FelipeS901/Trabajo-prevencion-incendios/docs/Arquitectura Operativa por Capas.jpg

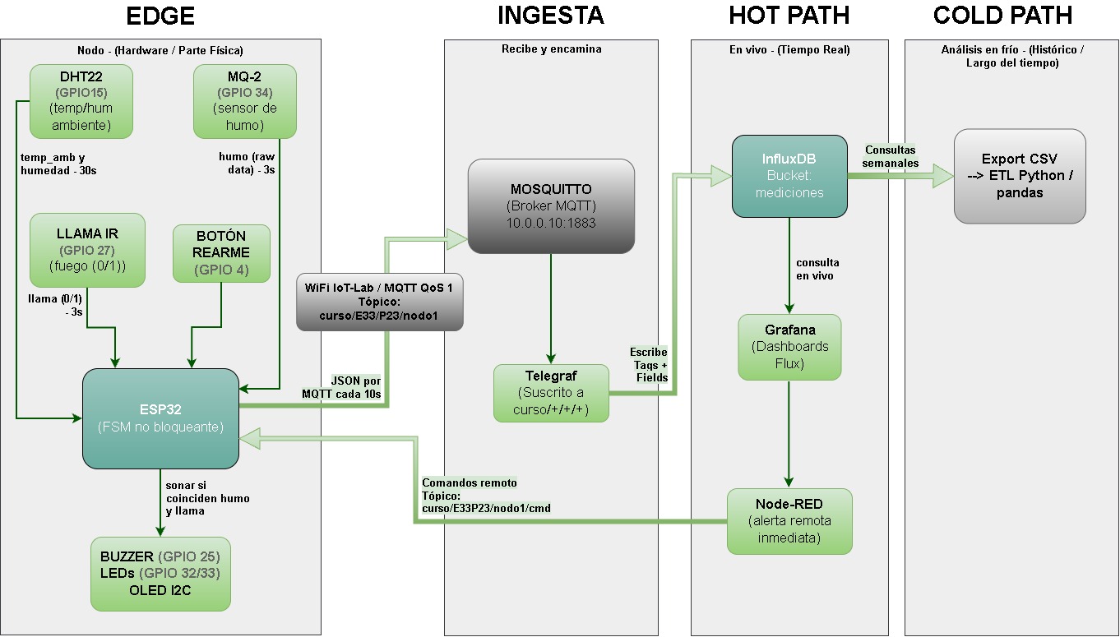
docs/Arquitectura Operativa por Capas.jpg
