FelipeS901/Trabajo-prevencion-incendios/README.md

# Nodo inteligente de detección de incendios

## Identificación del proyecto
- Equipo: **E33**
- Proyecto: **P23**
- Asignatura: **Fundamentos de IoT**
- Integrantes: Fiorella Bovet, Victoria Rojas, Felipe Stuardo, Arthur Urtubia y Javier Vidal

---

## Autoría y trazabilidad del firmware (Auditoría de contribuciones)

Para dar cumplimiento al criterio D7 (Autoría y trazabilidad) y a la retroalimentación de la Evaluación Regular 1, se detalla la contribución real de cada integrante del equipo E33.

### Hito 1: Evaluación Regular 1 — NP1: Nodo local

| Integrante | Módulo o tramo desarrollado | Evidencia |
| :--- | :--- | :--- |
| **Felipe Stuardo** | Gestión inicial del repositorio, organización de carpetas y creación de entregas. | [Historial de commits](https://github.com/FelipeS901/Trabajo-prevencion-incendios/commits/main/) |
| **Arthur Urtubia** | Desarrollo del código base, apoyo en las conexiones de hardware y realización de los cálculos matemáticos (calibración MQ-2, umbrales) necesarios para el funcionamiento del sistema. | [Código histórico de NP1](https://github.com/FelipeS901/Trabajo-prevencion-incendios/blob/main/CODIGOS/archivo-anterior/NP1_Codigo.ino) |
| **Javier Vidal** | Desarrollo del código base y apoyo en las conexiones de hardware. | [Código histórico de NP1](https://github.com/FelipeS901/Trabajo-prevencion-incendios/blob/main/CODIGOS/archivo-anterior/NP1_Codigo.ino) |
| **Fiorella Bovet** | Diseño de la máquina de estados, elaboración de diagramas, apoyo en la presentación y soldadura de componentes. | [Grafo de estados](https://github.com/FelipeS901/Trabajo-prevencion-incendios/blob/main/docs/Grafo-Estados.drawio) |
| **Victoria Rojas** | Elaboración de documentos de guía, organización del equipo, soldadura de componentes, elaboración de la presentación de NP1 y apoyo en el envío de entregas. | [Documentación del proyecto](https://github.com/FelipeS901/Trabajo-prevencion-incendios/tree/main/docs) |

### Hito 2: Evaluación Regular 2 — NP2: Sistema IoT conectado y persistido

En NP2, el equipo extendió el nodo local hacia un sistema conectado mediante MQTT y persistencia de datos. La distribución del trabajo se documenta por tramos funcionales y se respalda con archivos, funciones y commits del repositorio.

| Integrante | Contribución en NP2 y correcciones de NP1 | Evidencia |
| :--- | :--- | :--- |
| **Arthur Urtubia** | Desarrollo del modelo 3D y apoyo en la integración de mejoras de hardware. | [Carpeta Proyecto 3D](https://github.com/FelipeS901/Trabajo-prevencion-incendios/tree/main/Proyecto%203D) |
| **Javier Vidal** | Apoyo en la configuración MQTT, conexiones y lógica de envío de datos al broker. | [Función `publicarDatos()`](https://github.com/FelipeS901/Trabajo-prevencion-incendios/blob/main/CODIGOS/E33_P23_Firmware.ino#L923-L1005) |
| **Fiorella Bovet** | Apoyo en la edición del firmware, reconexión no bloqueante y actualización del grafo FSM a seis estados. | [Firmware actualizado](https://github.com/FelipeS901/Trabajo-prevencion-incendios/blob/main/CODIGOS/E33_P23_Firmware.ino) · [Grafo FSM](https://github.com/FelipeS901/Trabajo-prevencion-incendios/blob/main/docs/Grafo-Estados.drawio) |
| **Felipe Stuardo** | Documentación de GT4, apoyo en la gestión del repositorio, organización de entregas y apoyo en el desarrollo del modelo 3D. | [Historial del repositorio](https://github.com/FelipeS901/Trabajo-prevencion-incendios/commits/main/) |
| **Victoria Rojas** | Integración y actualización del firmware oficial, incluyendo el sensor MQ-2, revisión de tags/releases y la coordinación de cambios finales del repositorio. | [Commits de Victoria Rojas](https://github.com/FelipeS901/Trabajo-prevencion-incendios/commits/main/?author=vctoriaing) |

#### Correcciones de NP1 y aclaraciones de implementación

Tras revisar la retroalimentación docente, el equipo verificó el estado del firmware y la documentación, aplicando las siguientes mejoras y aclaraciones:

- **Grafo FSM:** Se confirma y documenta el uso del grafo de **6 estados** (`PRECALENTANDO`, `CALIBRANDO`, `VIGILANDO`, `SOSPECHA`, `ALARMA_CONFIRMADA`, `ERROR_SEGURO`) alineado con el firmware real.
- **Umbral MQ-2:** Se aclara que el firmware calcula el umbral de forma **adimensional (Rs/R0)**. Los valores en kΩ fueron corregidos, mostrando ahora los valores reales extraídos de la salida serial (`mq2_umbral: 0.67`).
- **Protección de Hardware:** El montaje físico cuenta con un filtro RC (resistencia de 1 kΩ y capacitor de 100 nF) en la entrada del GPIO 34. 
- **Tensión del regulador (LM2596):** Se documenta que la calibración física de la salida del regulador se realizó durante las primeras etapas de soldadura y montaje (a cargo de Victoria y Fiorella). Mediante el uso de un multímetro, se ajustó la perilla del regulador hasta obtener una salida estable de ~5V. Esta medición real es la que fundamenta el valor asignado a la constante `VC_SENSOR_MV` en el firmware, asegurando la precisión del cálculo Rs/R0.
- **Autoría:** Se agregó la tabla de trazabilidad por tramos en este README para cumplir con el criterio D7.
- **Lógica de confirmación de alarma (SOSPECHA):** Se analizaron las observaciones docentes sobre el retraso de la alarma en incendios lejanos (donde solo llega humo) y la falta de escalamiento ante humo persistente. Para esta entrega, se mantuvo de forma consciente la exigencia de 2 sensores para blindar el sistema contra falsas alarmas. Como trabajo futuro (Evaluación 3), se documenta la implementación de un contador de reincidencia (escalamiento por tiempo de exposición al humo) y la evaluación de un umbral térmico relativo a la temperatura ambiente.
---

## Descripción Técnica del Proyecto

### Sensores utilizados:
- DHT22 (temperatura y humedad)
- MQ-2 (humo)
- Sensor IR (llama)

### Funcionamiento
El nodo monitorea humo, llama y temperatura. Si al menos un sensor indica una condición de peligro, el sistema entra en SOSPECHA. La alarma se confirma cuando al menos dos de los tres sensores indican peligro simultáneamente.
La alarma confirmada activa el buzzer y el LED de alerta, y permanece enclavada hasta recibir un rearme manual o MQTT con la condición de peligro disipada.

### Umbrales sensores
- **DHT22:** Temperatura crítica: 60°C
- **MQ-2:** Caída mínima de humo: 30%. Umbral adaptativo MQ-2: MIN: 0,50 ; MAX: 0,85

### Tiempos y seguridad del sistema
- Estado de sospecha: 30 segundos
- Muestreo: 3 segundos
- Tolerancia a errores de lectura: 8 lecturas
- Precalentamiento sensor MQ-2: 3 minutos (tiempo en el cual no lee ni emite alarmas)

### Estados FSM publicados en `estado`
En el firmware actual, el campo `estado` del payload se publica como **valor numérico** según el enum de seis estados:
- `0 PRECALENTANDO`
- `1 CALIBRANDO`
- `2 VIGILANDO`
- `3 SOSPECHA`
- `4 ALARMA_CONFIRMADA`
- `5 ERROR_SEGURO`
- `6 ACTUANDO_REMOTO`

---

## Justificación de Umbrales e Histéresis

Las decisiones para configurar los tiempos, umbrales y guardias de seguridad en nuestra máquina de estados fueron actualizadas a partir de las revisiones docentes y el análisis de los sensores:

- **Precalentamiento y Calibración:** Se fijó un tiempo no bloqueante de 3 minutos (180 s) para permitir que el elemento calefactor del MQ-2 alcance el equilibrio térmico y limpie impurezas superficiales.
- **Línea Base y Umbral Adaptativo:** Tras el precalentamiento, se promedian 60 muestras (`N_MUESTRAS_CAL`) para calcular el umbral de activación para la condición de alerta/humo se define a partir de la caída de la razón Rs/R0, se define como una caída del 30% respecto a R0, sumado a 3 sigmas de la dispersión del montaje, asegurando que las fluctuaciones normales del aire limpio no crucen erróneamente el umbral de detección.
- **Umbrales Críticos:** Temperatura (`UMBRAL_TEMP_CRIT = 40.0 °C`) para evitar falsas alarmas por altas temperaturas ambientales y facilitar la activación en la presentación final del proyecto.
- **Persistencia de Fallos (`MAX_INVALIDAS = 8`):** Tolerancia de 8 muestras consecutivas con error (equivalente a 24 segundos) para filtrar ruido y commutar a `ERROR_SEGURO` ante fallas.
- **Ciclo for para alerta:** Está configurado para 2 minutos ya que actúa como un filtro temporal, garantiza que un aumento de temperatura registrado en el panel de `Grafana` no corresponda a un pico transitorio sino que una alerta catastrófica. 

---

## Evidencias y Simulaciones

### Wokwi (calibración de dos puntos)
https://wokwi.com/projects/472554117536717825
Utilizando Wokwi se logró simular la calibración de dos puntos usando un ESP32 y un potenciómetro, obteniendo los valores de m y b:
- m = 0,443
- b = -1,8764

### Maquina de estados
MaquinaDeEstados

### Montaje Hardware
MontajeProyecto

### Umbral del MQ-2

**(Corrección de Unidades y Matemática):** Se subsanó el error de la NP1 donde se presentaba el umbral como una resistencia en kΩ y se calculaba incorrectamente el porcentaje. Se aclara y documenta que el firmware calcula el umbral como una **razón adimensional (Rs/R0)**. 

- **Cálculo real:** Una caída base del 30% respecto a la línea base (1.0) arroja un umbral teórico inicial de 0.70, el cual es ajustado dinámicamente sumando 3 desviaciones estándar (3*sigma) para compensar el ruido del montaje.
- **Evidencia y datos reales:** Los valores se obtienen directamente de la salida serial del nodo, no de estimaciones teóricas. La calibración promedia exactamente **60 muestras** (tomadas cada 50 ms). En la última prueba, se obtuvo una línea base de 584 mV y un umbral adimensional real de `0.67`, el cual se ve reflejado en el payload JSON publicado (`"mq2_umbral": 0.67`).

*(Nota: El gráfico de estabilización adjunto muestra la curva de los mV crudos y filtrados hasta estabilizar la línea base en 584 mV. El umbral dinámico final de 0.67 no se dibuja como una línea estática porque el código lo calcula en tiempo real tras la calibración).*

#### Gráfico de estabilización (MQ-2)
mq-2 grafico

#### Evidencia JSON del Umbral Real
JSON Umbral

### Evidencias GT2
- **Ítem 6: Transición a Estado de Error** 
- **Ítem 7: Fusión de Sensores** 
- **Ítem 8: Histéresis Temporal** 

---

## Conectividad y Backend (GT4 / GT5)

### Tabla de Tópicos MQTT (GT4)
| Nombre del tópico | QoS | Retained | Descripción |
| :--- | :---: | :---: | :--- |
| `curso/E33/P23/nodo1` | 1 | Sí | JSON plano con temperatura, humedad, razón `Rs/R0`, llama, estado numérico y estado de sensores. |
| `curso/E33/P23/nodo1/estado` | 1 | Sí | Estado de disponibilidad MQTT: `online`/`offline`. |
| `curso/E33/P23/nodo1/cmd` | 1 | No | Recibe comandos JSON, incluyendo la solicitud de `rearme`. |

### Esquema de InfluxDB
- **Bucket:** `mediciones`
- **Measurement:** `mediciones`
- **Tags:** `equipo=E33`, `proyecto=P23`, `nodo=nodo1`
- **Fields:** Valores numéricos del payload.

---
### Comportamiento si el nodo deja de publicar
- Si pierde conexión o deja de publicar telemetría durante más de 5 minutos, la consulta Flux deja de recibir registros en la ventana de tiempo `(range(start: -5m))`, provocando que Grafana interprete la ausencia de flujo y conmute automáticamente la regla de alerta al estado `NoData`

---

## Estructura del Repositorio y Documentación

### Firmware oficial y versiones históricas
- **Firmware oficial:** `CODIGOS/E33_P23_Firmware.ino`.
- **Variante equivalente sin comentarios:** `CODIGOS/E33_1510`.
- **Versiones históricas/de desarrollo (no oficiales):** `CODIGOS/archivo-anterior/codigo-nodo.ino` y `CODIGOS/archivo-anterior/NP1_Codigo.ino`.

### Documentación en `docs/`
La documentación consolidada del proyecto está en `docs/`:
- PDF de lanzamiento: [`docs/E33_P23_Lanzamiento_Proyecto.pdf`](docs/E33_P23_Lanzamiento_Proyecto.pdf)
- Arquitectura por capas (actualizado): [`docs/Arquitectura Operativa por Capas.jpg`](docs/Arquitectura%20Operativa%20por%20Capas.jpg)
- Editables disponibles:
  - [`docs/Arquitectura-Capas.drawio`](docs/Arquitectura-Capas.drawio)
  - [`docs/Arquitectura-capas.json`](docs/Arquitectura-capas.json)
  - [`docs/Grafo-Estados.drawio`](docs/Grafo-Estados.drawio)
  - [`docs/Grafo-Estados.json`](docs/Grafo-Estados.json)

> Aclaración MQTT: se mantiene la tabla de tópicos y el payload del tópico de datos es **JSON plano**.
