FelipeS901/Trabajo-prevencion-incendios/NP1/README.md

# Material histórico de NP1

Esta carpeta conserva los archivos originales de la Evaluación 1.
La documentación vigente y editable se encuentra en `docs/`.
El firmware oficial actual se encuentra en `CODIGOS/E33_P23_Firmware.ino`.
