FelipeS901/Trabajo-prevencion-incendios/docs/Grafo-Estados.jpg

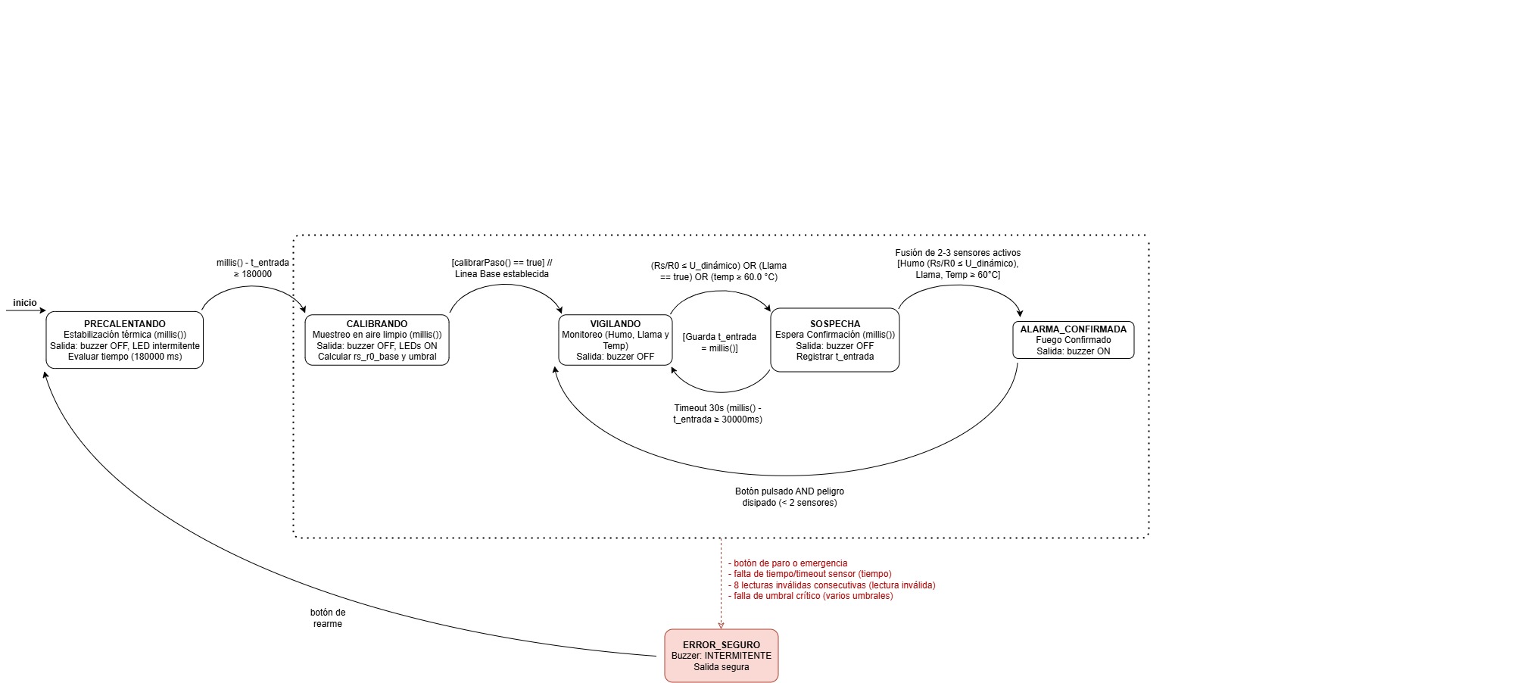
docs/Grafo-Estados.jpg
