FelipeS901/Trabajo-prevencion-incendios/Gt4/evidenciaConectividadA1.jpeg

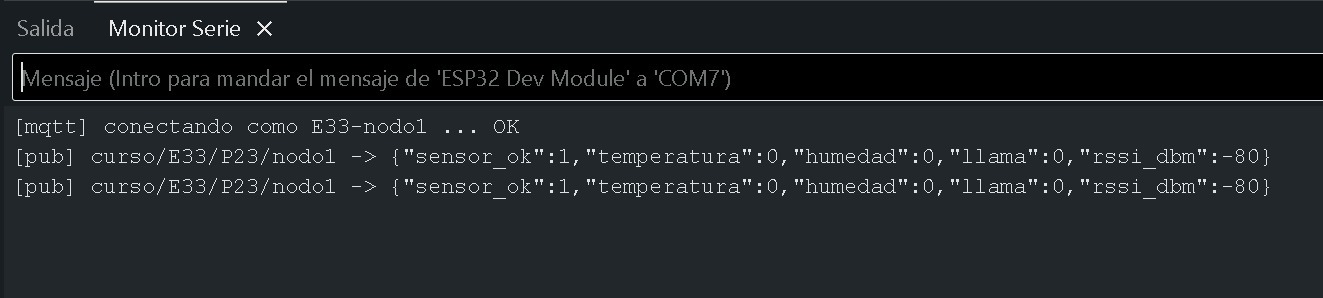
Gt4/evidenciaConectividadA1.jpeg
