FelipeS901/Trabajo-prevencion-incendios/GT4/MonitorSerieMuestra.jpeg

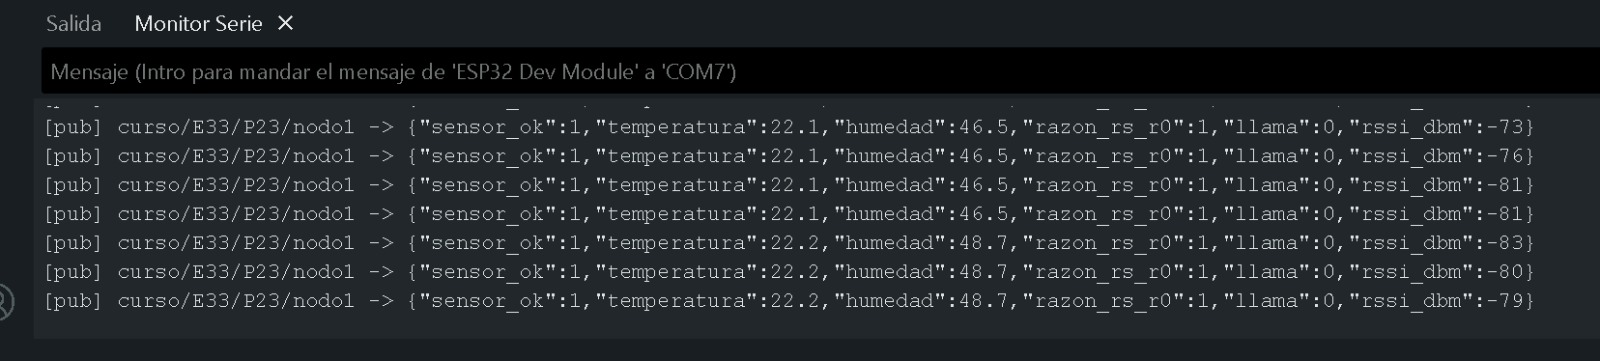
GT4/MonitorSerieMuestra.jpeg
