FelipeS901/Trabajo-prevencion-incendios/GT6/img/Dashboard Temperatura Maxima y Actuar.jpeg

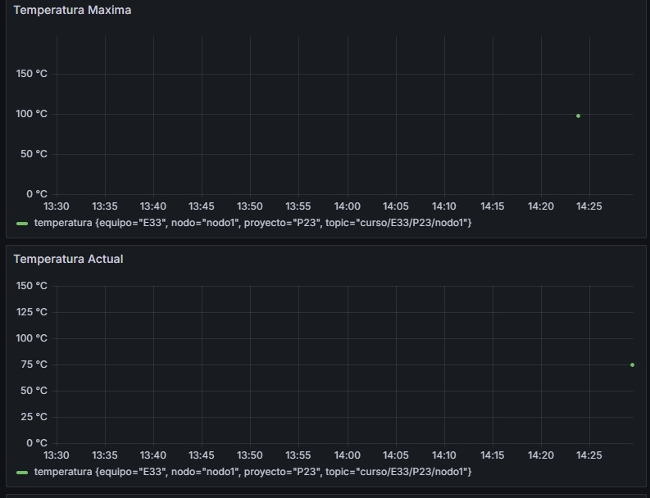
GT6/img/Dashboard Temperatura Maxima y Actuar.jpeg
