FelipeS901/Trabajo-prevencion-incendios/GT6/img/Dashboard.jpeg

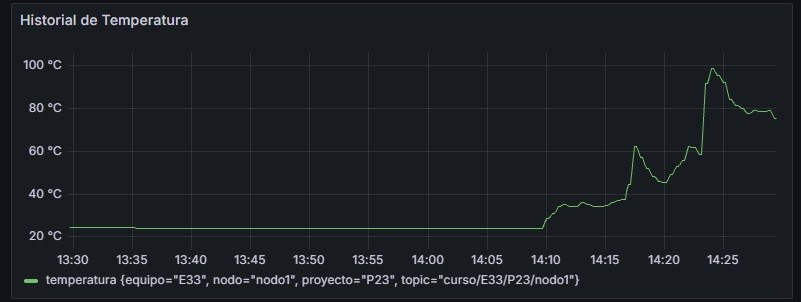
GT6/img/Dashboard.jpeg
