FelipeS901/Trabajo-prevencion-incendios/GT6/img/Firing.jpg

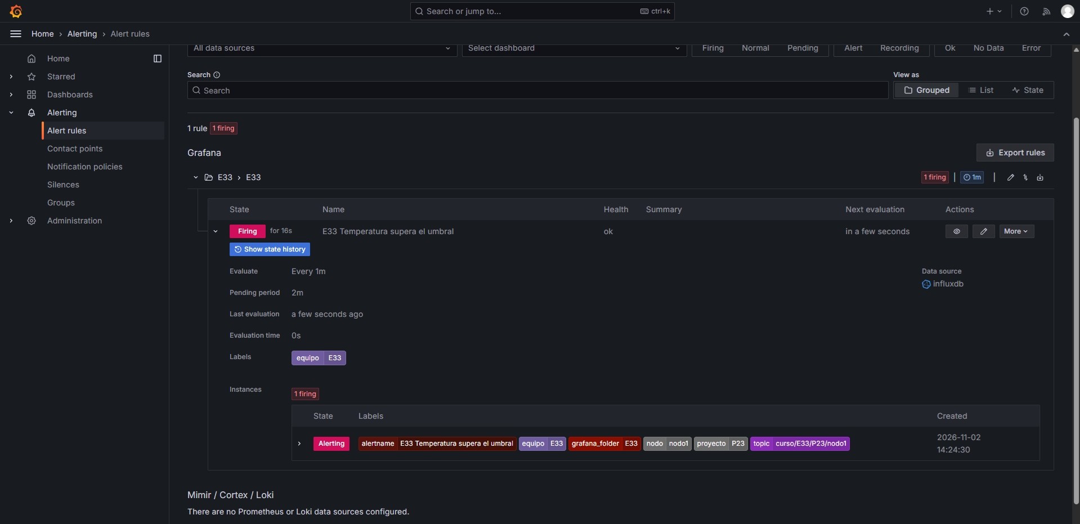
GT6/img/Firing.jpg
