FelipeS901/Trabajo-prevencion-incendios/Proyecto 3D/Base pilas.stl

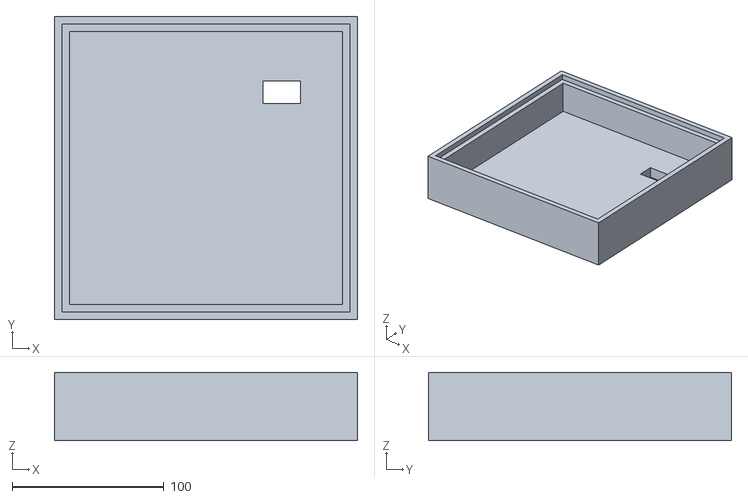
[picture p30: CAD file, 2026-10-21]
Proyecto 3D/Base pilas.stl
200.0 x 200.0 x 45.0
