FelipeS901/Trabajo-prevencion-incendios/Proyecto 3D/Casa IoT.stl

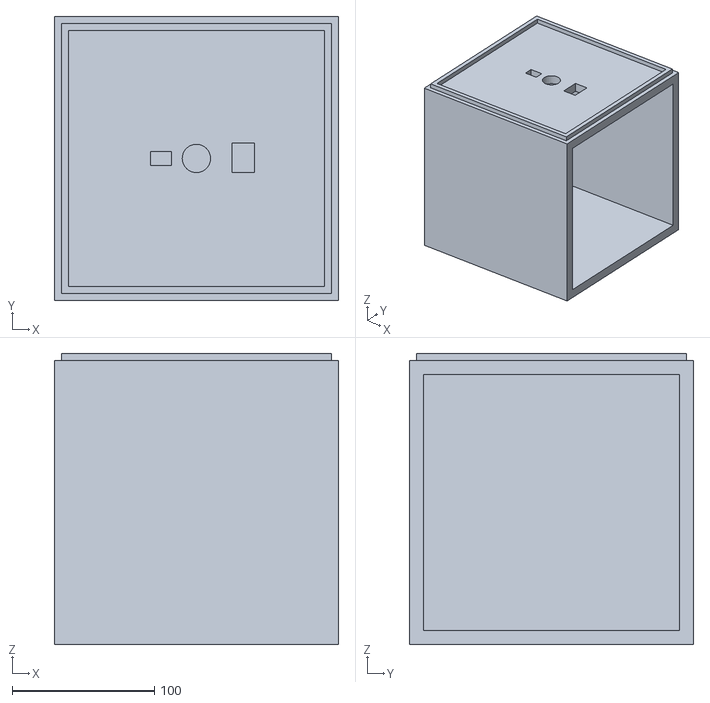
[picture p31: CAD file, 2026-10-21]
Proyecto 3D/Casa IoT.stl
200.0 x 200.0 x 205.0
