FelipeS901/Trabajo-prevencion-incendios/Gt4/VerificacionRecepcion.jpeg

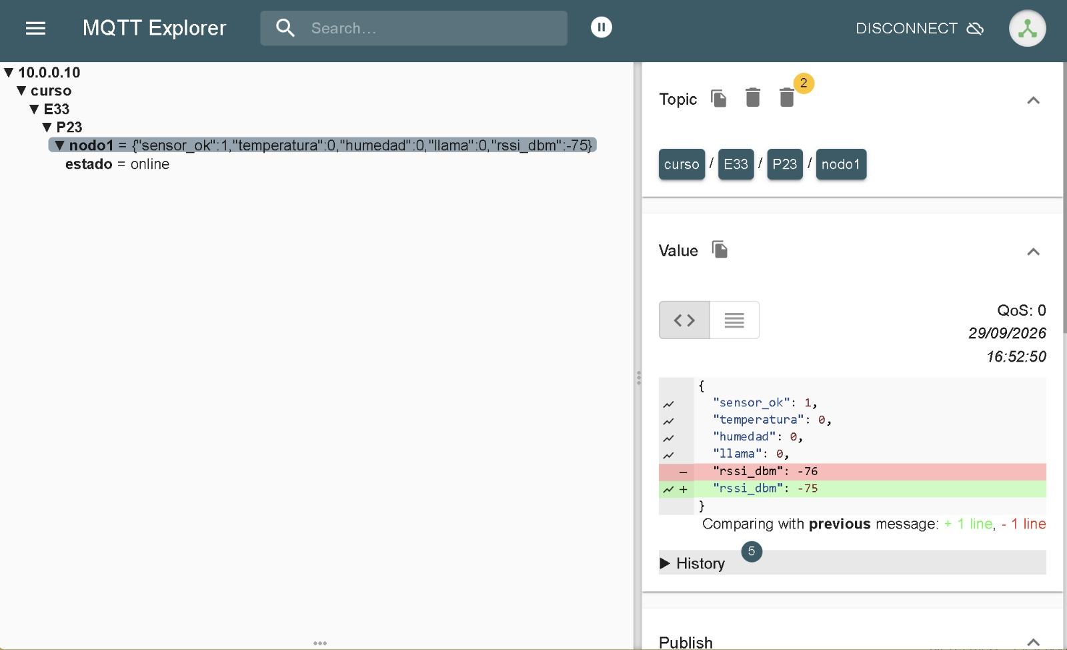
Gt4/VerificacionRecepcion.jpeg
