FelipeS901/Trabajo-prevencion-incendios/(commit log)

2026-08-09 Add files via upload
    Subida de diagrama de arquitectura e imagen exportada del proyecto P23.
2026-08-09 Agrega PDF de Lanzamiento de Proyecto
2026-08-16 Create Calibracion de dos puntos Wokwi
2026-08-24 Create Grafo de estados
2026-08-31 Enhance README with sensor verification and thresholds
    Added sections on physical sensor verification and threshold justification in the README.
2026-09-08 Add files via upload
    Archivo JSON del diagrama: Grafo de Estados
2026-09-08 Add files via upload
    Archivo JPG del diagrama: Grafo de Estados
2026-09-10 Add files via upload
    Archivo JSON Grafo de Estados / Maquina de Estados Finitos (FSM)
2026-09-10 Add files via upload
    Archivo .drawio Grafo de Estados / Maquina de Estados Finitos (FSM)
2026-09-10 Add files via upload
    Imagen Grafo de Estados / Maquina de Estados Finitos (FSM)
2026-09-10 Add files via upload
    PowerPoint NP1
2026-09-29 Update README.md
    Tabla de topicos
2026-09-29 Create config.example.h
    archivo de ejemplo de como va el config.h
2026-09-29 A3
    Evidencia del punto A3 de la gt4
2026-10-15 Add payload_sample.json with sensor data
2026-10-15 Add sensor monitoring and MQTT communication
    This file implements a system for monitoring temperature, humidity, and gas levels using various sensors, with MQTT for communication.
2026-10-15 Reorganizar documentación de NP1 hacia carpeta docs
2026-10-15 Add README.md with historical material information
2026-10-21 Revise README with project details and contributions
    Updated project identification, sensor details, and documentation structure. Enhanced clarity on system functionality and contributions from team members.
2026-10-21 Actualizar README con contribuciones y correcciones
    Se actualizó la sección de contribuciones y se añadieron correcciones y aclaraciones sobre el firmware y la implementación del proyecto. Se mejoró la documentación para reflejar cambios en el grafo FSM, el umbral de MQ-2 y la protección de hardware.
2026-10-21 Actualizar sección de calibración del MQ-2
    Se corrigió el cálculo del umbral del MQ-2 y se documentaron los datos reales obtenidos de la salida serial del nodo. Se añadieron imágenes y detalles sobre la calibración y el cálculo del umbral.
2026-10-21 Corrige umbral del MQ-2 y añade evidencias gráficas
    Se corrigieron errores en la presentación del umbral del MQ-2, aclarando el cálculo del umbral como una razón adimensional. Se añadieron gráficos y evidencias JSON para respaldar los datos.
2026-10-21 Arquitectura Operativa por Capas
    Diagrama de la cadena construida especificando sensores y actuadores, microcontrolador, enlace, broker o plataforma, registro y visualización, incluyendo los nombres reales de los tópicos.
2026-10-21 Arquitectura Operativa por Capas (JPEG)
    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
2026-11-01 Fix: Consumir bandera de rearme MQTT en FSM
    Se limpia la variable rearmeMQTSPendiente tras procesarla en ejecutarFSM() para evitar un falso rearme permanente o un bloqueo de la alarma local. Cumple con la integración de comandos remotos de Node-RED (GT6).
2026-11-02 E33_P23_Firmware
    (Actualizado para GT6)
2026-11-02 Create Grafana
    Es el Dashboard.json de grafana
2026-11-02 Create temporal
    solo para poder crear la carpeta de imagenes
2026-11-02 Imagenes solicitadas para la GT6
    Firing y Dashboards
2026-11-03 comportamiento caso nodo deje de publicar README.md
2026-11-03 Improve comments on DHT reading publication
    Refactor comments for clarity on temperature and humidity publication logic.
